tinmazemir/Teknofest_Fetih1453_2019/Tasarim/Fetih.jpg

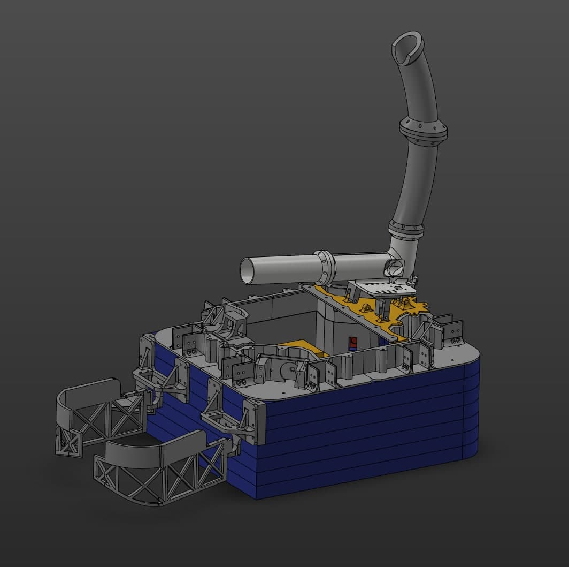
Tasarim/Fetih.jpg
