tinmazemir/Teknofest_Fetih1453_2019/Tasarim/PCBs/megabrd.png

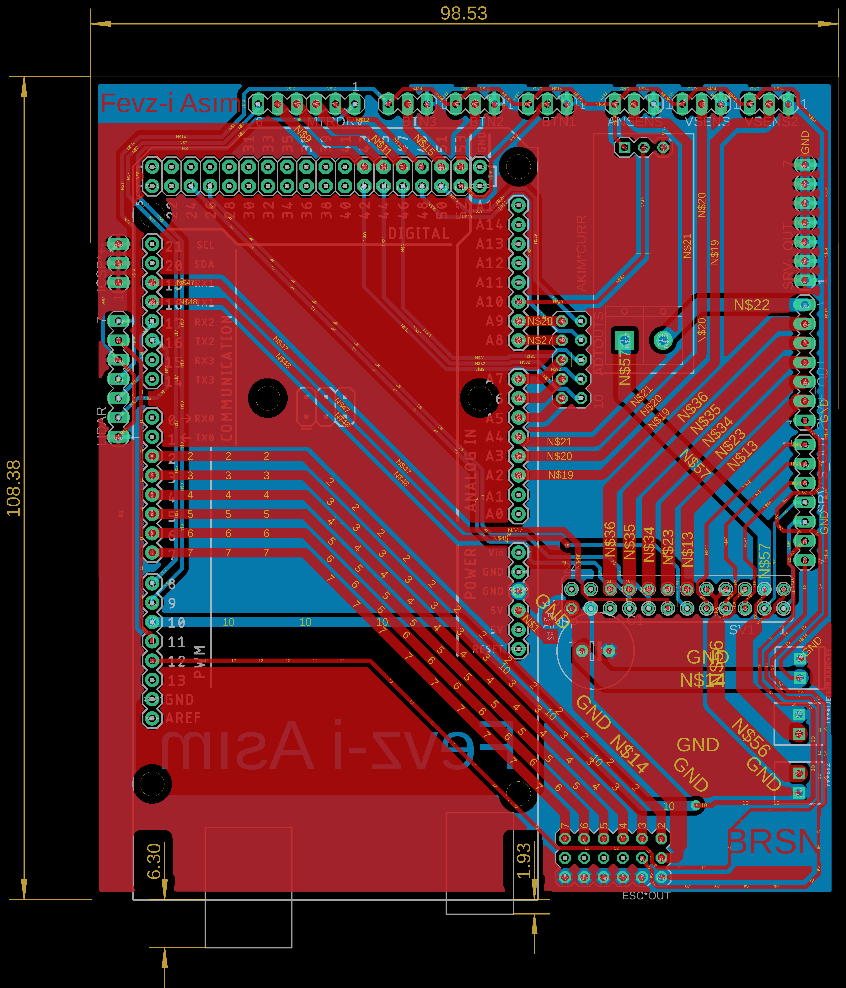
Tasarim/PCBs/megabrd.png
