tinmazemir/Teknofest_Fetih1453_2019/Tasarim/PCBs/pcbnanobrd.png

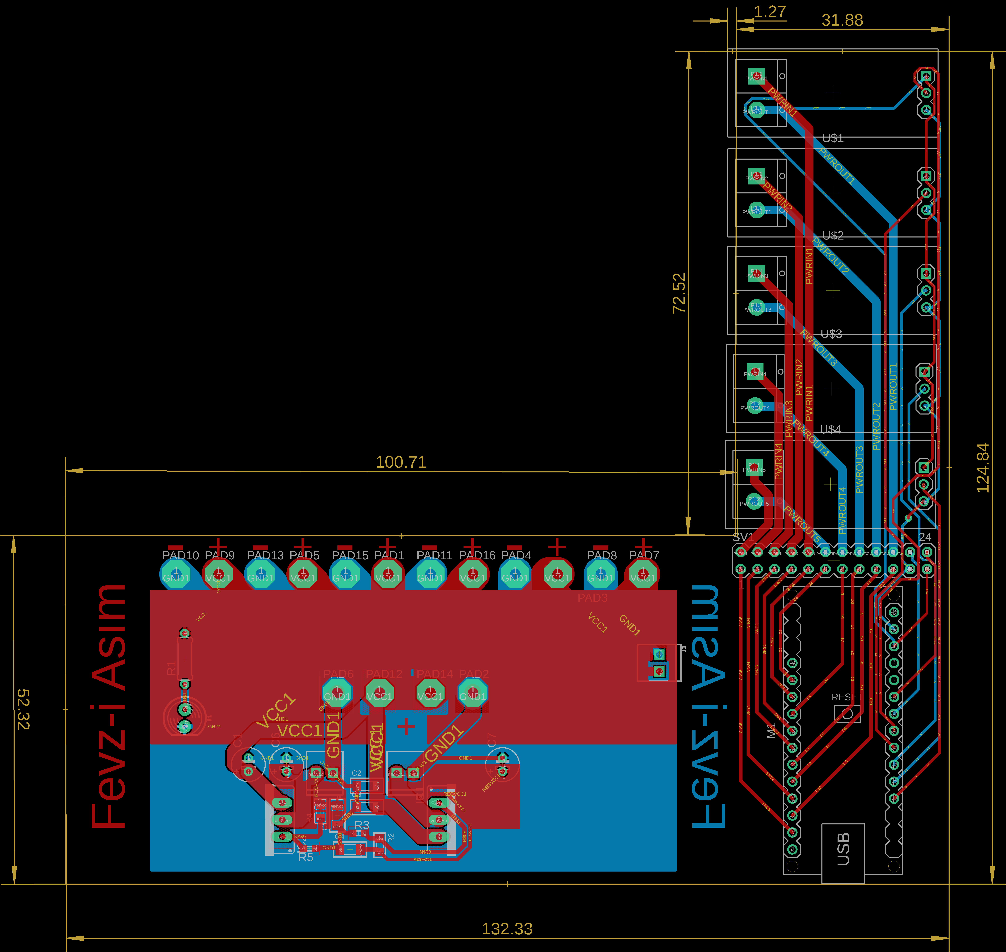
Tasarim/PCBs/pcbnanobrd.png
